GorenzelgProjects/IoT_Final_Project/3D-design/pictures/3D.png

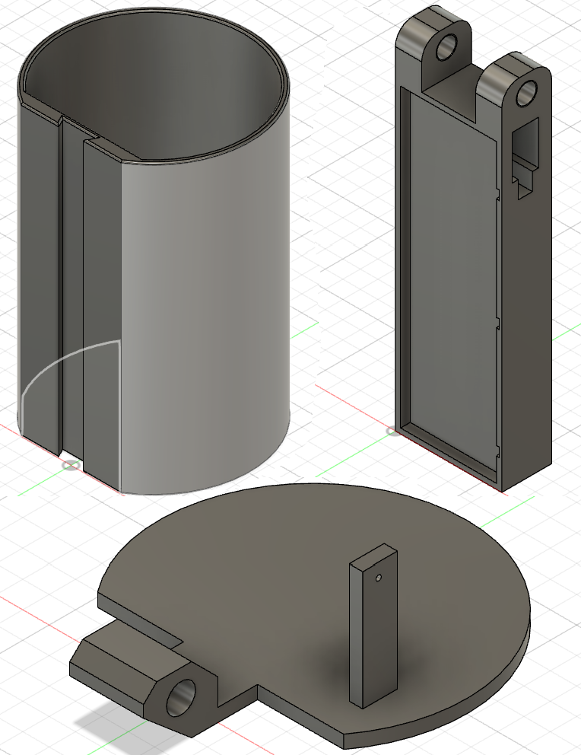
3D-design/pictures/3D.png
