GorenzelgProjects/IoT_Final_Project/3D-design/pictures/cookiejar.jpg

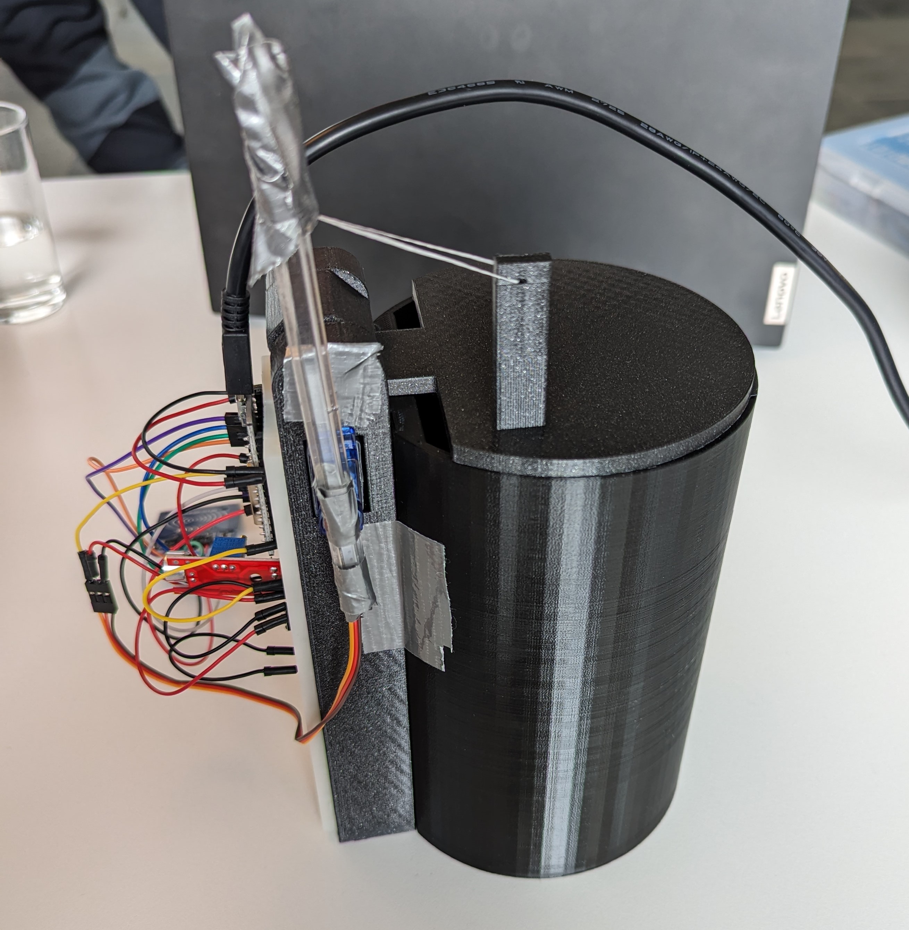
3D-design/pictures/cookiejar.jpg
