GorenzelgProjects/IoT_Final_Project/README.md

# IoT_Final_Project
Exam Project IoT 34315
