GorenzelgProjects/IoT_Final_Project/3D-design/pictures/bread.png

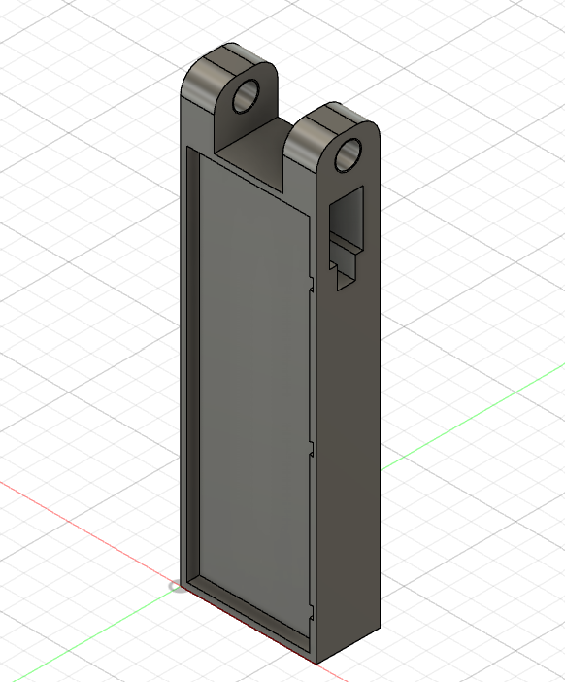
3D-design/pictures/bread.png
