GorenzelgProjects/IoT_Final_Project/3D-design/pictures/jar.png

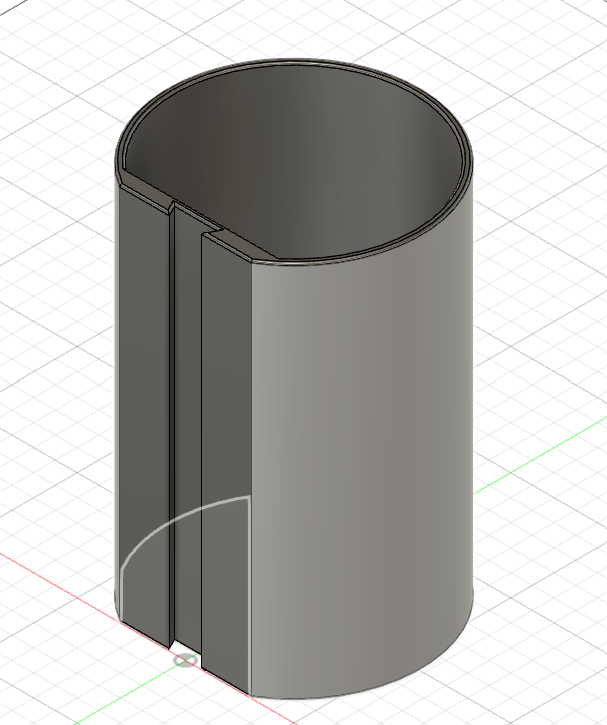
3D-design/pictures/jar.png
