GorenzelgProjects/IoT_Final_Project/3D-design/pictures/lid.png

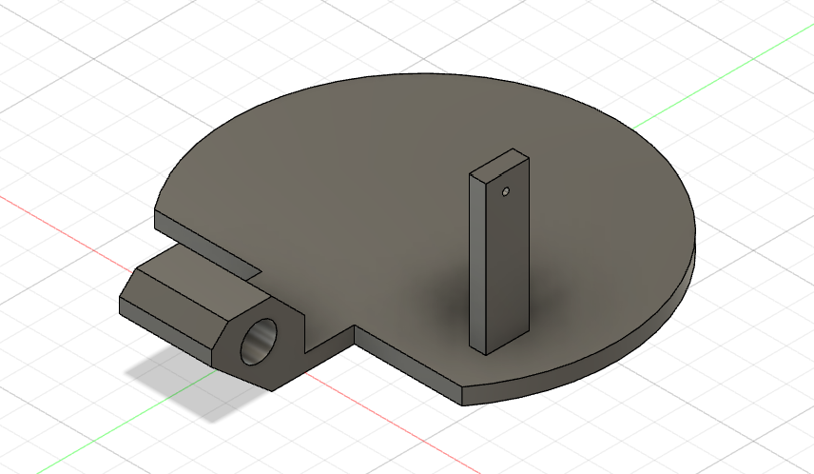
3D-design/pictures/lid.png
