GorenzelgProjects/IoT_Final_Project/Fritzing/circuitDiagram_V2.png

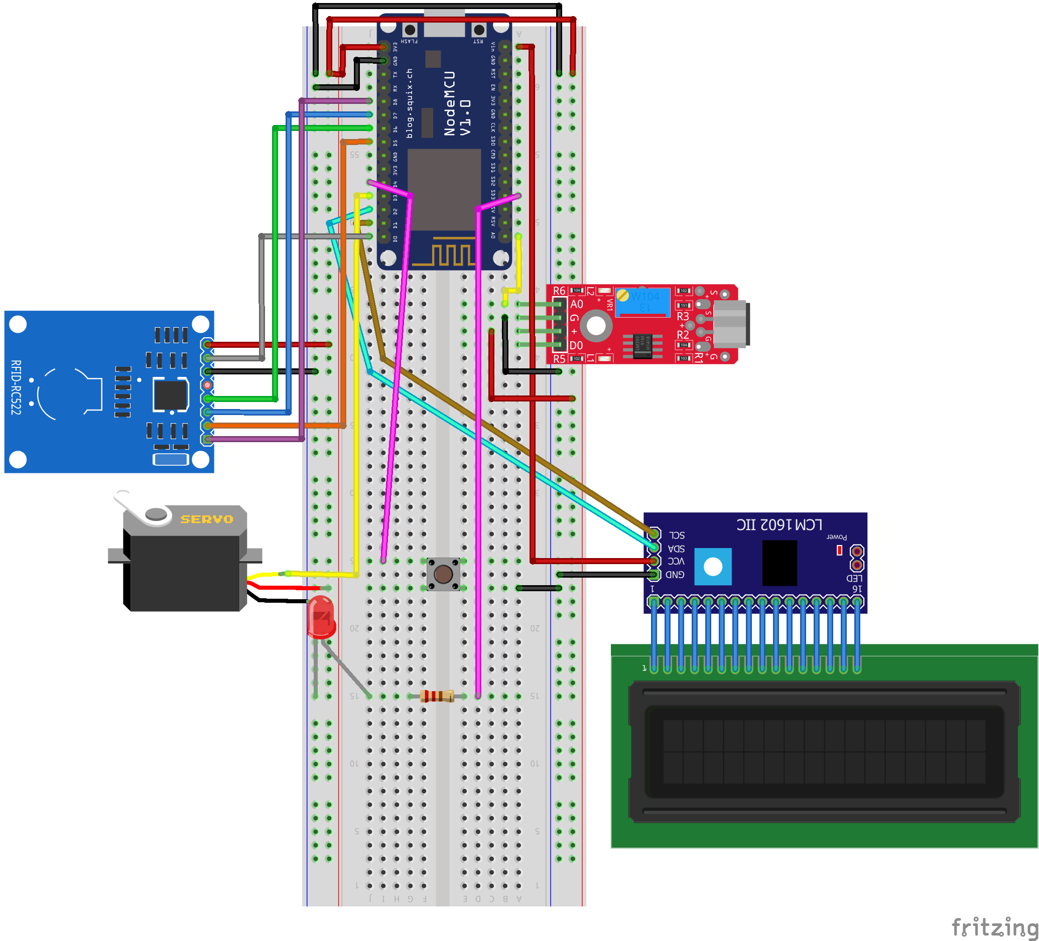
Fritzing/circuitDiagram_V2.png
