GorenzelgProjects/IoT_Final_Project/3D-design/modular Cookie jar fusion files/new cookie jar v8 HOPEFULLY final.stl

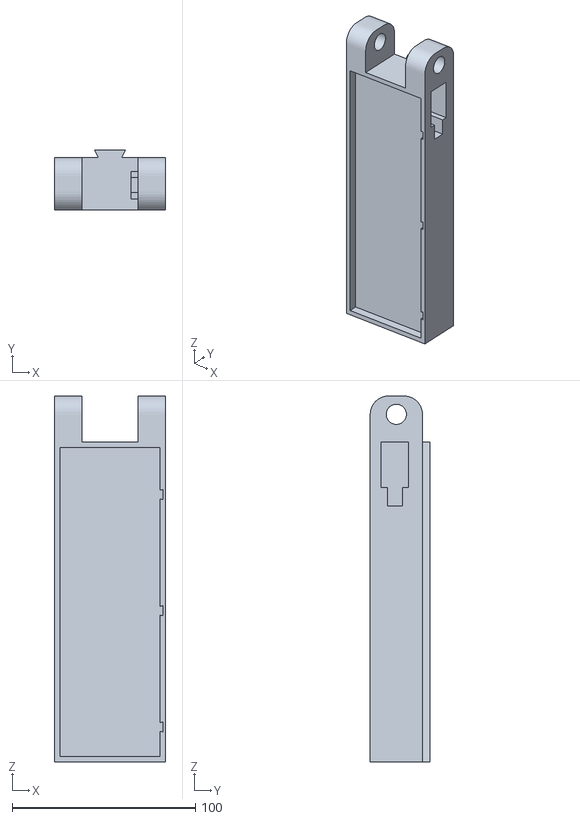
[picture p16: CAD file, 2024-05-01]
3D-design/modular Cookie jar fusion files/new cookie jar v8 HOPEFULLY final.stl
60.8 x 32.5 x 199.5
