GorenzelgProjects/IoT_Final_Project/3D-design/modular Cookie jar fusion files/new_cookie_jar_lidt (v2~recovered).stl

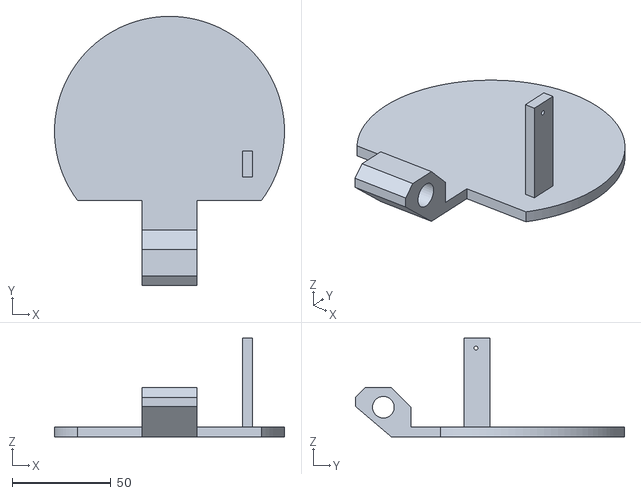
[picture p18: CAD file, 2024-05-01]
3D-design/modular Cookie jar fusion files/new_cookie_jar_lidt (v2~recovered).stl
116.6 x 136.5 x 50.0
