GorenzelgProjects/IoT_Final_Project/3D-design/modular Cookie jar fusion files/Cookie_jar.stl

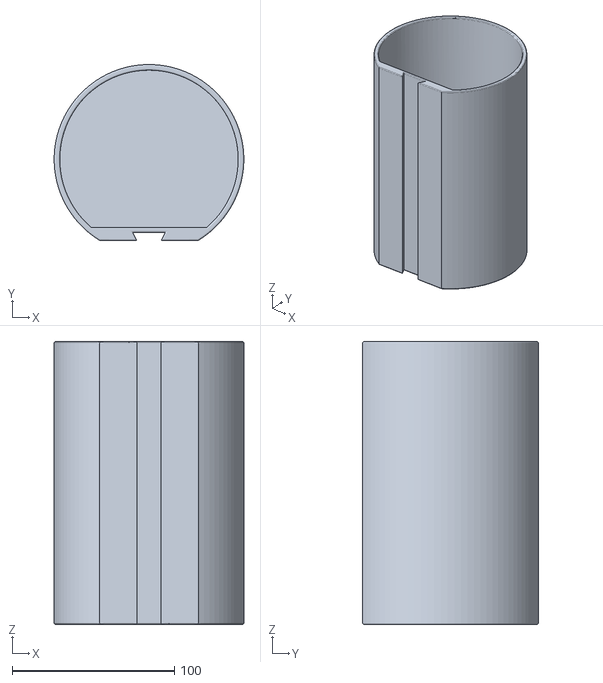
[picture p19: CAD file, 2024-04-18]
3D-design/modular Cookie jar fusion files/Cookie_jar.stl
117.0 x 108.5 x 174.5
