GorenzelgProjects/IoT_Final_Project/3D-design/modular Cookie jar fusion files/Cookie_lid.stl

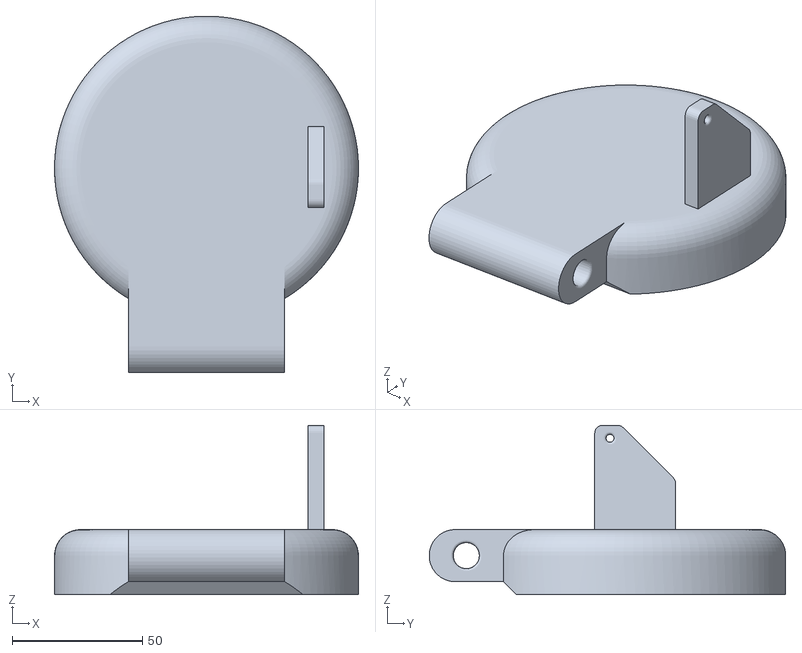
[picture p20: CAD file, 2024-04-18]
3D-design/modular Cookie jar fusion files/Cookie_lid.stl
116.6 x 136.8 x 65.0
