GorenzelgProjects/IoT_Final_Project/3D-design/modular Cookie jar fusion files/Cookie_hinge.stl

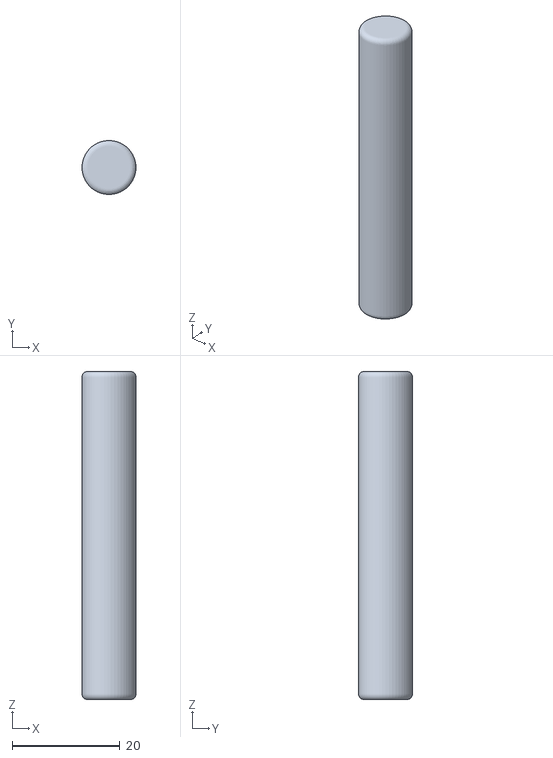
[picture p21: CAD file, 2024-04-18]
3D-design/modular Cookie jar fusion files/Cookie_hinge.stl
10.0 x 9.98 x 60.8
