GorenzelgProjects/IoT_Final_Project/3D-design/modular Cookie jar fusion files/Cookie_breadboard_holder.stl

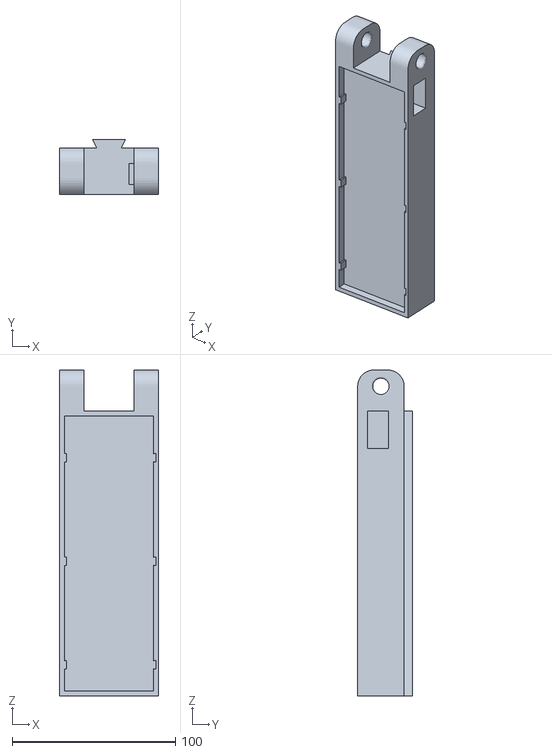
[picture p22: CAD file, 2024-04-18]
3D-design/modular Cookie jar fusion files/Cookie_breadboard_holder.stl
60.8 x 33.5 x 199.5
