GorenzelgProjects/IoT_Final_Project/(list of files, cad)

Other CAD files:
3D-design/Cookie Jar v7.f3d
3D-design/modular Cookie jar fusion files/Cookie jar lidt v2.f3d
3D-design/modular Cookie jar fusion files/Cookie part of jar v2.f3d
3D-design/modular Cookie jar fusion files/new cookie jar v7.f3d
