GorenzelgProjects/IoT_Final_Project/(list of files, drawings)

Other design files:
Fritzing/circuitDiagram.fzz
Fritzing/parts/Arduino-Uno-r3-with-RFID-RC522.fzz
