GorenzelgProjects/IoT_Final_Project/Code-esp8266-final/secrets.h

// Use this file to store all of the private credentials 
// and connection details

#define SECRET_SSID "MySSID"                                // replace MySSID with your WiFi network name
#define SECRET_PASS "MyPassword"                            // replace MyPassword with your WiFi password

#define SECRET_CH_ID 2522707                                 // replace 0000000 with your channel number
#define SECRET_WRITE_APIKEY "G5WG42VHHEELJ3I4"                           // replace XYZ with your channel write API Key
#define SECRET_READ_APIKEY "8KDFZQ0JZEUZTZ2S"                    //for read
