GorenzelgProjects/IoT_Final_Project/(commit log)

2024-04-04 FirstTest upload
    Creating circuit diagram where we can also similate
    [circuitDiagram.fzz]
2024-04-10 added 3d-design first iteration
    [Cookie Jar v7.f3d]
2024-04-10 Almost done circuit diagram V1
    [circuitDiagram.fzz]
2024-04-10 V1 Circuit diagram done
    Circuit diagram should be all the way done got the lcd screen added with the help of a 74HC595 bit shifter
    [circuitDiagram.fzz]
2024-04-10 Parts used in circuit diagram
    Added the parts that was not in fritzing to start with too so others can get them faster (RFID is part of a bigger one but just add to bin when open there)
    [Arduino-Uno-r3-with-RFID-RC522.fzz]
2024-04-10 Small updates CircuitDiagram
    Had to swap a few pins around so rst went to d0 and then changed some colors
    [circuitDiagram.fzz]
2024-04-16 created new 3D files for a modular cookie jar
    [Cookie jar lidt v2.f3d, Cookie part of jar v2.f3d, new cookie jar v7.f3d]
2024-04-18 added .STLs
    [Cookie_breadboard_holder.stl, Cookie_hinge.stl, Cookie_jar.stl, Cookie_lid.stl]
2024-04-20 LCD to I2C
    Updated circuit diagram, and made basic code for the display
    [circuitDiagram.fzz]
2024-04-24 Self-made data and ML models needed for ML-pipeline
    Added trained model ("feedforwardnet.pth"), python script for training "CNN_Clap_our_data.py", model testing script "Test_CNN_our_data.py", data shuffling script "randomize_csv.py" and the selfcreated data and their labels.
    Furthermore added older versions of the models and training for progression purposes.
    [iot_samples_labels.csv, iot_samples_labels_random.csv, labeled_dataset.csv, labels_dataset.csv, labels_dataset_random.csv]
2024-04-25 Update circuitDiagram
    Added a button on D4 so we can add users
    [circuitDiagram.fzz]
2024-04-25 updated printscreen code
2024-04-25 fix RFID in same folder
    [Code-esp8266.ino, RFID.ino]
2024-04-26 Create labeled_dataset.csv
    added crucial dataset_file
    [labeled_dataset.csv]
2024-04-30 Almost forgot to upload
    Should have added all the things togther need to clean file alot
    Also need to add the openLock in the loop somewhere after sound is okay
    [circuitDiagram.fzz]
2024-04-30 Update sound A0->10
    [circuitDiagram.fzz]
2024-05-01 Changed 3D files; added poster
    [new cookie jar v8 HOPEFULLY final.stl, new_cookie_jar_lidt (v2~recovered).stl, new_cookie_jar_lidt v2.stl]
2024-05-02 small stuff
    [circuitDiagram.fzz]
2024-05-08 FIXED CIRCUIT DIAGRAM
    [circuitDiagram.fzz]
2024-05-08 small stuff with screen print
